Levi-Throop/AstroBerth-Senior-Design/README.md

# AstroBerth-Senior-Design
# Project Summary

Our team was tasked with solving the problem of inefficient cargo storage on the International Space Station (ISS). The current storage system uses bungee cords to hold cargo bags in place, resulting in disorganization and wasted time for astronauts when stowing and retrieving cargo.

To address this issue, we formulated a solution that utilizes the capabilities of the Astrobee robot, which is already deployed on the ISS. Specifically, we created a cargo berth fixture that is mounted on the walls of the ISS and uses an esp32cam microprocessor, a camera, and a magnet to allow the Astrobee to autonomously stow and retrieve cargo bags.

Our cargo berth fixture incorporates a fiducial marker and a steel strike plate on the bags, which allows the fixture to track the marker and send coordinates to the Astrobee to guide it in mating the magnet and steel strike plate on the bag, thus successfully stowing the bag. The fixture also includes a switch that signals when the bag has been mounted properly, as well as a deep sleep mode and a light module switch. 

The deep sleep mode ensures that the fixture is not wasting energy when not in use, while the light module switch enables the Astrobee's built-in flashlight to activate the fixture and prepare it for the next task. When designing our solution, we had ease of use and safety in mind. The berth fixture is constructed using lightweight material and fasteners that stay in place after they are unscrewed. This ensures that when the crew changes out the batteries which power the device, there is zero chance for the hardware to fall out and get lost, possibly causing issues with other systems.

We also designed the fixture to be fastened to the wall of the ISS using Velcro. Using this material allows the fixture to be secured but easily removed if they decide to relocate them or need to make any adjustments. Also, the steel strike plate has been attached to the front of the cargo bag allowing any interaction with the magnet on the fixture to not interfere with any precious materials or electronics the bag may contain. Of course, when packing the materials, the ground crew should package the bag in such a way that most vulnerable items to be placed farthest away from the plate as a counter measure.

Lastly, the berth fixture was designed to be as power conservative as possible. Our thought process on this, is that if we want to utilize the Astrobee to take over the task of stowing/retrieving the cargo bags in an autonomous way, requiring the crew to manually change out the power source too frequently would be counterproductive. That is why we included the flashlight module with the goose neck attachment and the mount switch on the face of the fixture. Together, they allow the berth fixture to go into deep sleep mode and only power on when Astrobee needs to remove a cargo bag from its stowed location since the magnet is always magnetized until the berth fixture is powered on and sends current to it.

# Project Block Diagram
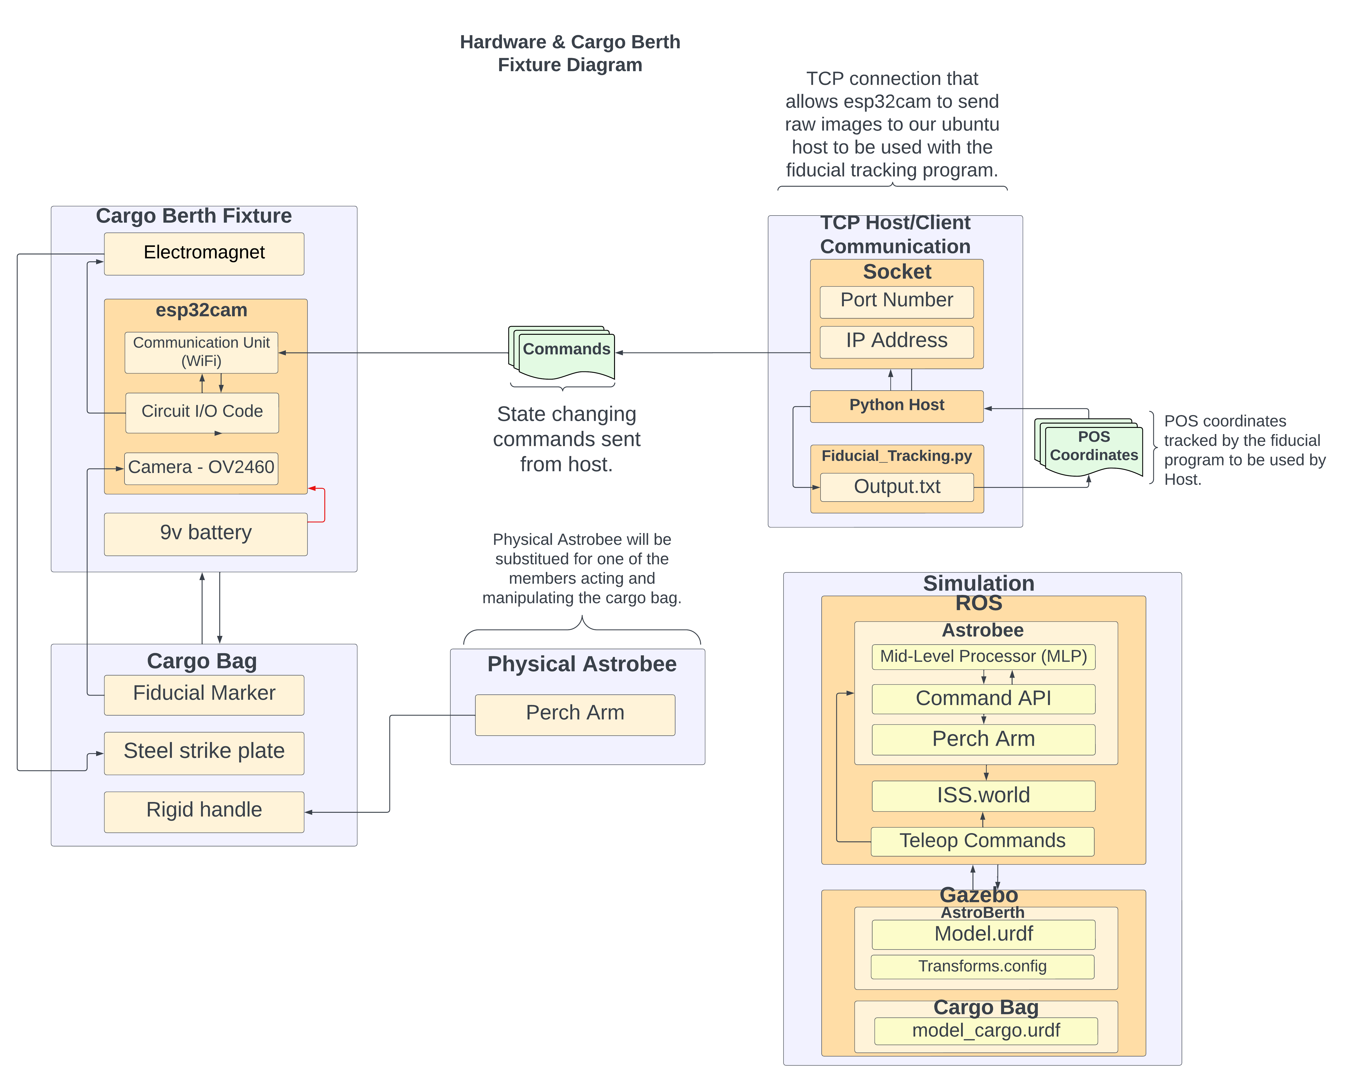
[picture p1: 3_21_23 Demo Block.png]

## Block Diagram

The block diagram outlines the interactions between the different systems involved in our project. The cargo berth fixture, located on the left side of the diagram, houses the magnet, camera, and power supply. It interacts with the cargo bag through fiducial tracking and mating with the steel strike plate. TCP communication over a local hotspot connection allows the fixture to receive commands from our Python host. The fiducial tracking program saves position coordinates which the host uses to guide the user in adjusting the position of the cargo bag during the mating process. This allows a team member to physically manipulate the bag and guide it to the berth fixture.

To simulate this process, we used a NASA-built simulation environment utilizing ROS and Gazebo. Our cargo berth fixture’s .urdf files and transform were added to the environment, allowing us to highlight the interaction between the fixture, robot, and bag in a virtual space.

# 3D Model Diagram
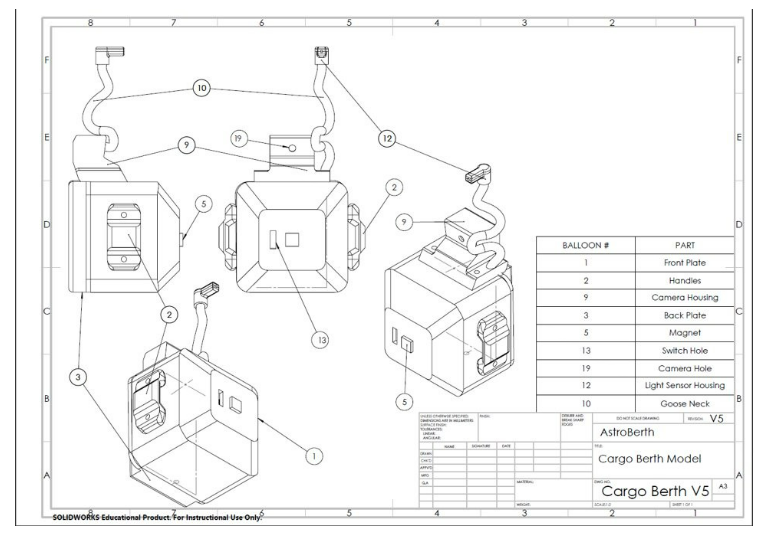
[picture p2: model_diagram.png]


### 3.3.3 3D Modeling Diagram 

The accompanying image displays a comprehensive breakdown of our model. The entire model was manufactured using 3D printing with PLA plastic and securely assembled with M4 inserts and machined screws. 

To ensure optimal performance, we carefully placed the cameras at a considerable distance from the magnet to allow uninterrupted reading of the fiducial marker when the bag is fully installed, as depicted in balloons 9 and 19. 

Balloon 1 illustrates the front plate of our cargo berth, which features precision cutouts specifically designed to accommodate the switch and magnet arrangement. These cutouts are prominently visible in balloons 5 and 13. Balloon 2 displays handles on either side of the AstroBerth, facilitating easy handling of the product. 

Balloon 3 portrays the backplate of the AstroBerth, ingeniously housing our batteries. Our design further incorporates a goose neck design, illustrated in balloon 10, that enables facile maneuvering of the light sensor on top of the cargo berth around the cargo bags. 

Finally, balloon 12 highlights the light sensor housing that encompasses our light sensor, specifically intended for deep sleep operation modes, reflecting our relentless pursuit of innovative solutions.

# State Diagram

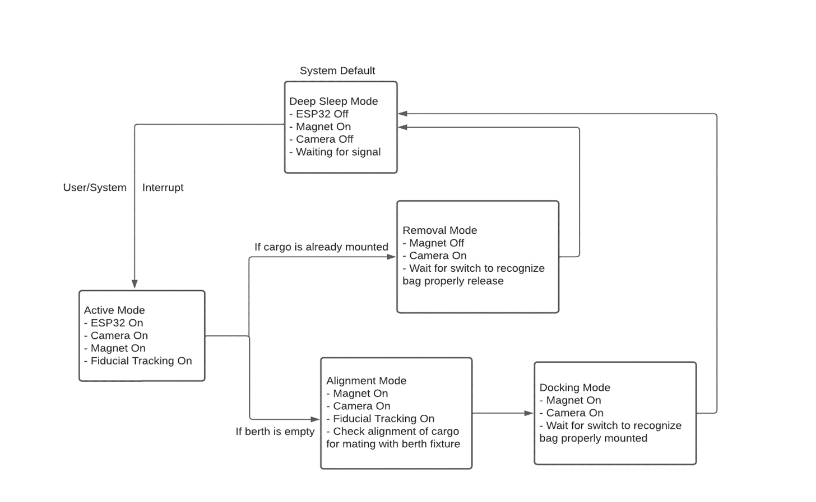
[picture p3: state_diagram.png]


## 3.3.4 State Diagram 

The state diagram above illustrates the different modes that the Astroberth can operate in and the transitions between them. The default mode of the Astroberth is the deep sleep mode, where the ESP32 is off, the magnet is holding the cargo, and the camera is off to conserve power. 

When a signal is received from the Astrobee's flashlight, the ESP32 will transition into its active mode with the camera and fiducial tracking active. The Astroberth then waits to receive information about which mode it will be operating in, based on a signal sent from the Astrobee.

If the berth fixture does not have a bag mounted, it will transition into the alignment mode, where the ESP will communicate with the Astrobee to use the camera and fiducial tracking to mount the bag. Once the bag is in a certain position, the docking mode is activated, and the berth waits for the switch on the bag to be active, indicating that the bag is mounted properly. After the bag is mounted properly, the ESP goes back into its deep sleep mode.

If a cargo bag is already mounted, the bag will transition from its active mode to the removal mode. The removal mode will have the camera on to note the positioning of the bag, and the magnet will be released when the Astrobee is in position. The ESP applies a voltage to the circuit controlling the magnet, allowing the bag to drop. Once the bag is removed, indicated by the switch on the berth, the berth will go back into its deep sleep mode.

# Magnet Circuit (Patent Pending)
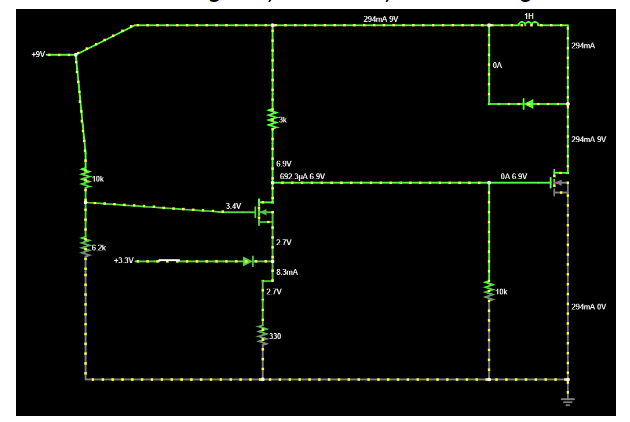
[picture p4: magnet_circuit.png]


## 3.3.1 Magnet Circuit Diagram

The magnet circuit diagram displays how the magnet is controlled by the ESP32. The circuit consists of a solenoid, a permanent magnet, a switch, and a battery. The switch represents the input pin of the ESP32 that delivers 3.3V when the bag removal mode is activated. 

When the input pin is active, the voltage at the nodes of the circuit changes to allow the current from the battery to flow through the solenoid, which cancels out the magnetic field from the permanent magnet. This allows the magnet to release the cargo bag from the berth. 

This circuit design is efficient as it only uses power when a bag needs to be removed from the berth.

# Light Sensor Circuit
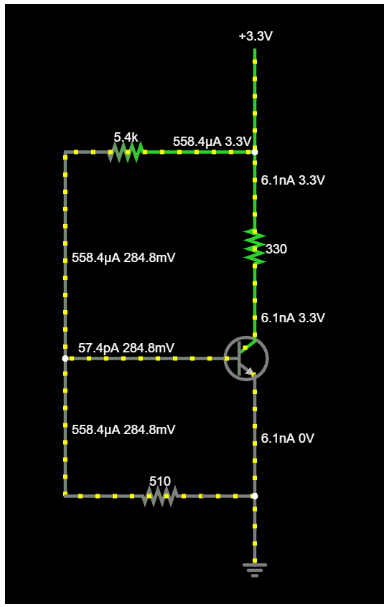
[picture p5: light_sensor_circuit.png]


## 3.3.2 Light Sensor Circuit Diagram 

The light sensor circuit diagram depicts how a photoresistor and NPN transistor work together to trigger a signal to pass to the microprocessor whenever light shines onto the photoresistor. The circuit is designed to minimize its usage of current when the photoresistor is in the dark. 

When light shines onto the photoresistor, its resistance drops, causing the transistor's state to flip and lower the voltage on the circuit by grounding it. The microprocessor, connected between the 330 Ohm resistor and the NPN transistor, is then able to register the signal dropping to low and exit its sleeping state to begin connection to the Astrobee.

The photoresistor is housed in a metal gooseneck attached to the berth fixture, which positions it in a way that allows the Astrobee's flashlight to reach it, as depicted in the 3.3.4 use case diagrams.

# Use Case 
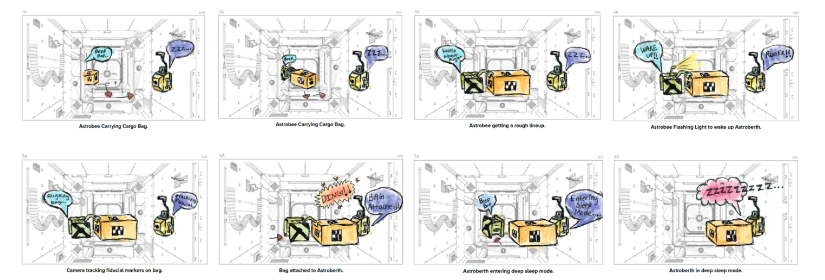
[picture p6: concept_of_designs.png]


### 3.3.4 – 3.3.5 Use Case Diagrams 

The following use case diagrams illustrate the different steps involved in the docking and undocking process between Astrobee and AstroBerth:

#### Docking Use Case Diagram:

1. Astrobee navigates through the International Space Station (ISS).
2. Astrobee carries a cargo bag and determines the optimal location to mount it.
3. Astrobee activates the AstroBerth by sending a wake-up signal using its flashlight.
4. Astrobee uses fiducial tracking to guide the cargo bag into the precise mating position.
5. The steel plate of the cargo bag magnetizes against the AstroBerth.
6. Astrobee departs the scene, and the AstroBerth enters a power-saving deep sleep mode.

#### Undocking Use Case Diagram:

1. Astrobee initiates the undocking process by approaching the AstroBerth and activating its flashlight module.
2. The AstroBerth releases the cargo bag, allowing the Astrobee to transport it to its intended location.
3. After the undocking process is complete, the AstroBerth enters into a power-conserving deep sleep mode.

# IRL AstroBerth (Senior Design Showcase Group 7)
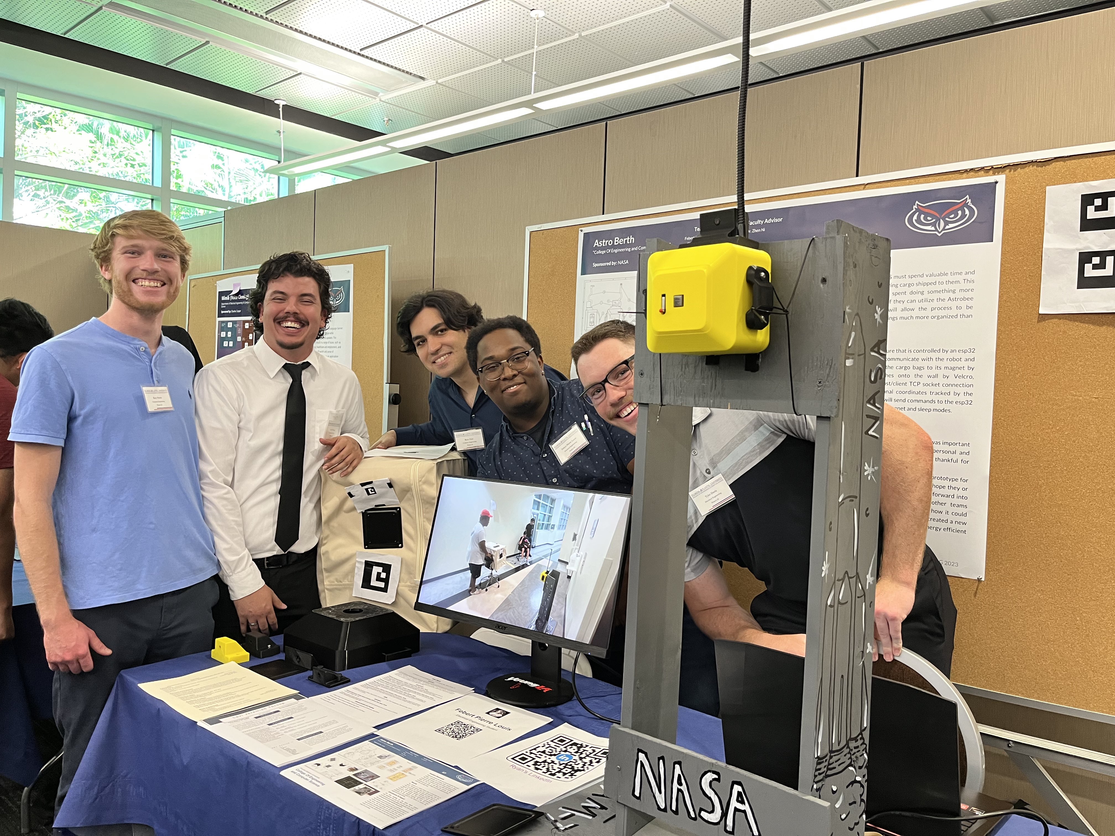
[picture p7: group_photo.jpg]
