Levi-Throop/AstroBerth-Senior-Design/(commit log)

2023-05-10 Fixed indentation and spacing
    [Host.py]
2023-05-10 Added circuit images
2023-05-10 Added model.urdf file and group photo
    [model.urdf]
